hide4096/TadpoleEx/README.md

# TadpoleEx
第18回全日本学生室内飛行ロボットコンテスト自動操縦部門に出場した機体のプログラムと回路図
