hide4096/TadpoleEx/PCB/README.md

# 2022TadpoleEx_KiCAD
第18回飛行ロボットコンテスト自動操縦部門 TadpoleEx用基板
