hide4096/TadpoleEx/CAD/notuse/Ultrasonic_holderV2.stl

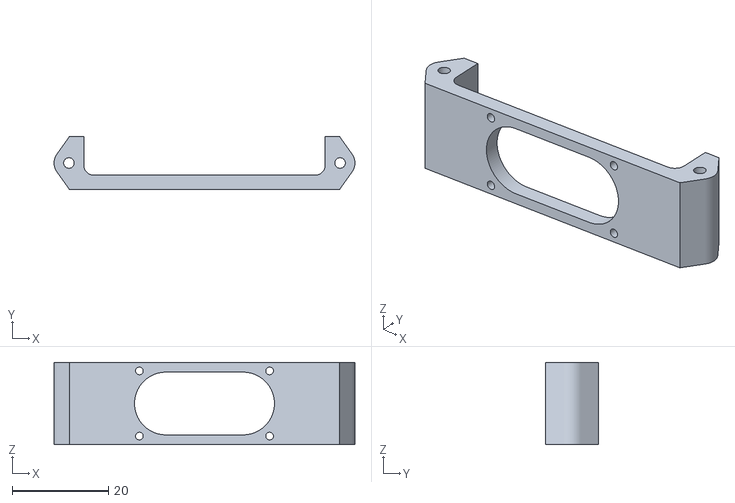
[picture p1: CAD file, 2022-12-09]
CAD/notuse/Ultrasonic_holderV2.stl
62.4 x 11.0 x 17.0
