hide4096/TadpoleEx/(list of files, cad)

Other CAD files:
CAD/TadpoleEx/TailWing.dwg
CAD/TadpoleEx/om_Body_3.0.dwg
CAD/TadpoleEx/om_Body_2.0.dwg
CAD/TadpoleEx/Band_Cap.ipt
CAD/TadpoleEx/Drop/OldVersions/neji.0001.ipt
CAD/TadpoleEx/Drop/OldVersions/om_Drop.0025.iam
CAD/TadpoleEx/Drop/OldVersions/om_DropBase.0005.ipt
CAD/TadpoleEx/Drop/OldVersions/om_DropBase_10g.0002.ipt
CAD/TadpoleEx/Drop/OldVersions/om_DropBase_8g.0001.ipt
CAD/TadpoleEx/Drop/OldVersions/om_Drop_10g.0004.iam
CAD/TadpoleEx/Drop/OldVersions/om_Drop_10g_L.0001.ipt
CAD/TadpoleEx/Drop/OldVersions/om_Drop_10g_R.0001.ipt
CAD/TadpoleEx/Drop/OldVersions/om_Drop_L.0012.ipt
CAD/TadpoleEx/Drop/OldVersions/om_Drop_R.0021.ipt
CAD/TadpoleEx/Drop/OldVersions/om_Drop_bumper.0007.ipt
CAD/TadpoleEx/Drop/OldVersions/om_Drop_shaft.0004.ipt
CAD/TadpoleEx/Drop/OldVersions/om_Drop_shaft_10g.0001.ipt
CAD/TadpoleEx/Drop/joint.ipt
CAD/TadpoleEx/Drop/neji.ipt
CAD/TadpoleEx/Drop/om_Drop.iam
CAD/TadpoleEx/Drop/om_DropBase.ipt
CAD/TadpoleEx/Drop/om_DropBase_10g.ipt
CAD/TadpoleEx/Drop/om_Drop_10g.iam
CAD/TadpoleEx/Drop/om_Drop_10g_L.ipt
CAD/TadpoleEx/Drop/om_Drop_10g_R.ipt
CAD/TadpoleEx/Drop/om_Drop_L.ipt
CAD/TadpoleEx/Drop/om_Drop_R.ipt
CAD/TadpoleEx/Drop/om_Drop_bumper.ipt
CAD/TadpoleEx/Drop/om_Drop_shaft.ipt
CAD/TadpoleEx/Drop/om_Drop_shaft_10g.ipt
CAD/TadpoleEx/Drop/saponSEX_ver3.iam
CAD/TadpoleEx/HoriMove.ipt
CAD/TadpoleEx/HoriWing.ipt
CAD/TadpoleEx/HornHolder.ipt
CAD/TadpoleEx/MainMotor._Newipt.ipt
CAD/TadpoleEx/MainMotor.ipt
CAD/TadpoleEx/MainRod.ipt
CAD/TadpoleEx/MainWing.ipt
CAD/TadpoleEx/MainWing_3.0.ipt
CAD/TadpoleEx/MainWing_4.0.ipt
CAD/TadpoleEx/MainWing_5.0.ipt
CAD/TadpoleEx/MainWing_flat_印刷.ipt
CAD/TadpoleEx/MainWing_印刷.ipt
CAD/TadpoleEx/OldVersions/MainWing_5.0.0005.ipt
CAD/TadpoleEx/OldVersions/om_HIKOROBO_3.0.0022.iam
CAD/TadpoleEx/Propeller.ipt
CAD/TadpoleEx/ServoMotor.ipt
CAD/TadpoleEx/ServoMotor_10g.ipt
CAD/TadpoleEx/ServoMotor_8g.ipt
CAD/TadpoleEx/ServoMotor_Holder.ipt
CAD/TadpoleEx/ServoMotor_Holder_V2.ipt
CAD/TadpoleEx/TailHorn.ipt
CAD/TadpoleEx/Tail_Set.iam
CAD/TadpoleEx/Tire_Φ50.ipt
CAD/TadpoleEx/VertMove.ipt
CAD/TadpoleEx/VertWing.ipt
CAD/TadpoleEx/Wheel_Φ50.ipt
CAD/TadpoleEx/WireHolder.ipt
CAD/TadpoleEx/chicken.ipt
CAD/TadpoleEx/horn.ipt
CAD/TadpoleEx/horn_10g.ipt
CAD/TadpoleEx/kiban.ipt
CAD/TadpoleEx/kibanHolder.ipt
CAD/TadpoleEx/om_BackHolder.ipt
CAD/TadpoleEx/om_BackHolder_R.ipt
CAD/TadpoleEx/om_BackHolder_V2.ipt
CAD/TadpoleEx/om_BackHolder_V3.ipt
CAD/TadpoleEx/om_BackHolder_V4.ipt
CAD/TadpoleEx/om_Body_2.0.idw
CAD/TadpoleEx/om_Body_2.0.ipt
CAD/TadpoleEx/om_Body_3.0.ipt
CAD/TadpoleEx/om_Body_L.ipt
CAD/TadpoleEx/om_Body_R.ipt
CAD/TadpoleEx/om_Drop.idw
CAD/TadpoleEx/om_HIKOROBO.iam
CAD/TadpoleEx/om_HIKOROBO_2.0.iam
CAD/TadpoleEx/om_HIKOROBO_3.0.iam
CAD/TadpoleEx/om_Interior.iam
CAD/TadpoleEx/om_Interior_2.0.iam
CAD/TadpoleEx/om_MotorMount.ipt
CAD/TadpoleEx/om_MotorMount_2.0.ipt
CAD/TadpoleEx/om_MotorMount_2.1.ipt
CAD/TadpoleEx/om_MotorMount_3.0.ipt
CAD/TadpoleEx/om_MotorMount_4.0.ipt
CAD/TadpoleEx/om_MotorMount_4.1.ipt
CAD/TadpoleEx/om_TailFrontHolder.ipt
CAD/TadpoleEx/om_TailFrontHolder_FP.ipt
CAD/TadpoleEx/om_TailRod.ipt
CAD/TadpoleEx/om_TailRod_FP.ipt
CAD/notuse/Gear/GearBase.ipt
CAD/notuse/Gear/GearV1.iam
CAD/notuse/Gear/Holder's Shaft.ipt
CAD/notuse/Gear/OldVersions/GearBase.0009.ipt
CAD/notuse/Gear/OldVersions/GearV1.0013.iam
CAD/notuse/Gear/OldVersions/gear_connecotr1.0016.ipt
CAD/notuse/Gear/OldVersions/gear_connecotr1_V2.0001.ipt
CAD/notuse/Gear/OldVersions/gear_connector2.0013.ipt
CAD/notuse/Gear/OldVersions/gear_rod.0005.ipt
CAD/notuse/Gear/OldVersions/gear_shaft.0001.ipt
CAD/notuse/Gear/OldVersions/om_gear_base1.0007.ipt
CAD/notuse/Gear/Tire_Φ50.ipt
CAD/notuse/Gear/Wheel_Φ50.ipt
CAD/notuse/Gear/Wheel_Φ50.newVer.ipt
CAD/notuse/Gear/gear_connecotr1.ipt
CAD/notuse/Gear/gear_connecotr1_V2.ipt
CAD/notuse/Gear/gear_connector2.ipt
CAD/notuse/Gear/gear_rod.ipt
CAD/notuse/Gear/gear_shaft1.ipt
CAD/notuse/Gear/gear_test.iam
CAD/notuse/Gear/om_gear_base1.ipt
CAD/notuse/Gear/om_gear_base2.ipt
CAD/notuse/UltrasonicSensor.ipt
CAD/notuse/Ultrasonic_holderV1.ipt
CAD/notuse/Ultrasonic_holderV2.ipt
CAD/notuse/Ultrasonic_holderV3.ipt
CAD/notuse/Ultrasonic_holderV4.ipt
CAD/notuse/Ultrasonic_holderV5.ipt
