hide4096/TadpoleEx/Fc_esp32.pdf

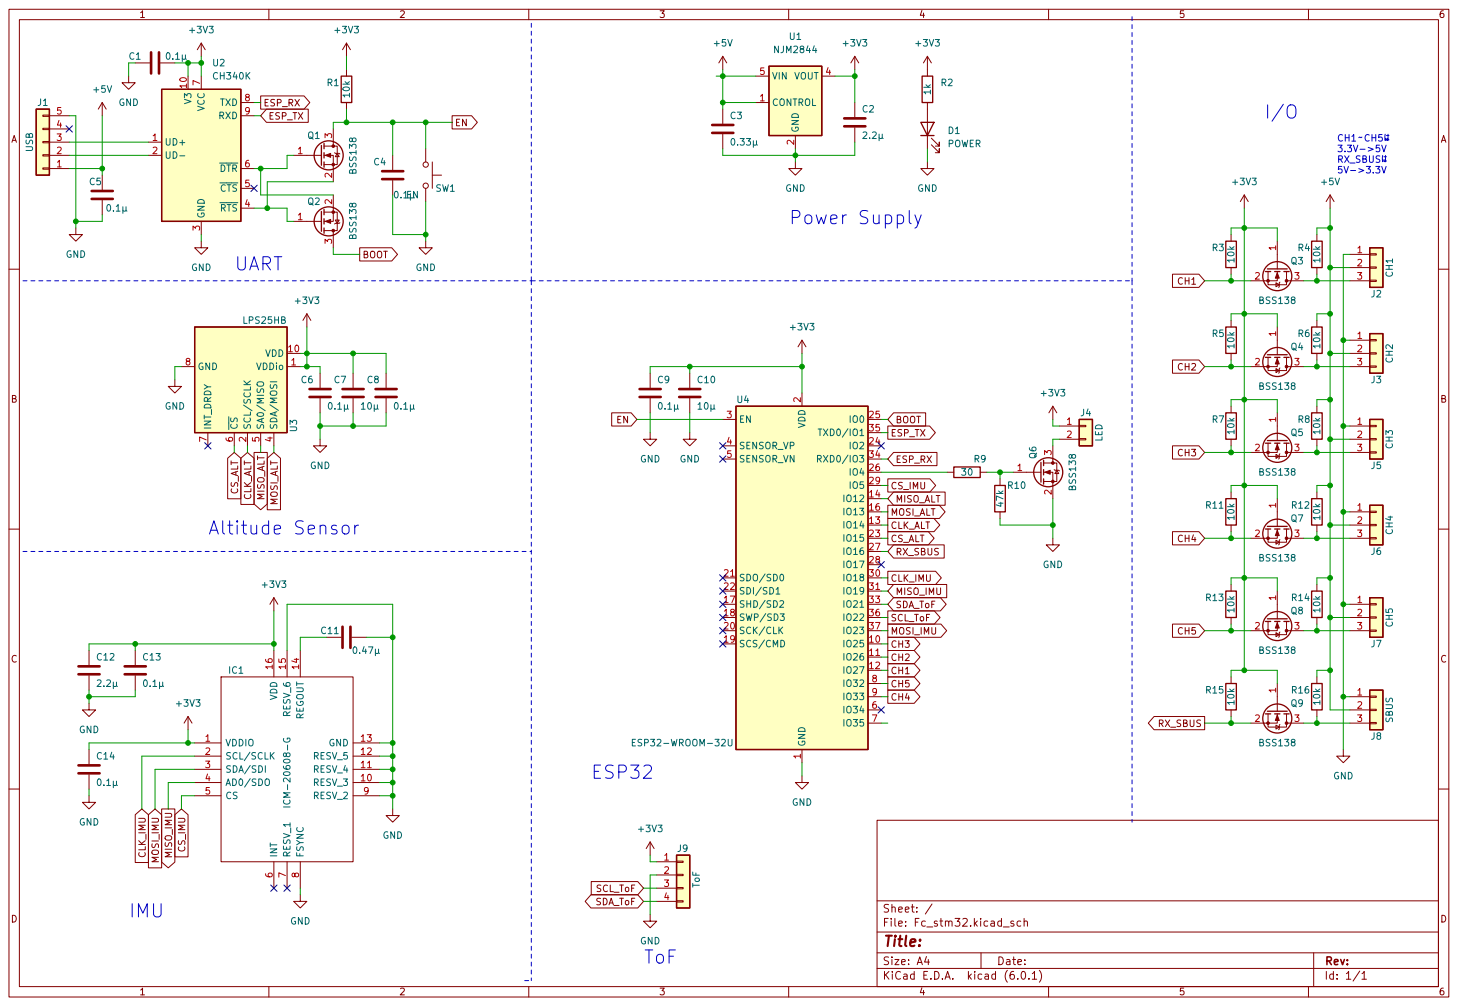
[picture p2: page 1]

3 ~{RTS} 4 ~{CTS} 5 ~{DTR} 6 VCC

2 SCK/CLK 20 SDO/SD0 21 SDI/SD1 22
