hide4096/TadpoleEx/(commit log)

2022-08-22 [update]IMU,大気圧センサのドライバ書いた
2022-08-27 [update]サーボ制御をマルチスレッド化
2022-08-27 [update]UDP通信追加
2022-08-28 [fix]フリーズを修正
2022-08-28 [update]自動水平旋回を実装
2022-08-28 [fix]放送内容を変更
2022-08-28 [update]ログで吐く情報を追加
2022-08-29 [update]角速度を指定して旋回できるようにした
2022-08-30 [update]ToF追加
2022-09-02 [add]基板データ追加
    [Fc_stm32.kicad_pcb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]
2022-09-10 [update]Adjust PID Gain and altitude LPF Gain
2022-09-15 [fix] 着陸誘導方式を変更
2022-09-18 [update]自動操縦動画提出版
2022-09-21 [update]自動旋回のゲインを調整
2022-09-21 [update]全ミッション実装
2022-09-21 [fix]ヨーのアレを修正
2022-09-22 [update]ゲインを調整
2022-09-22 [updare]ゲインを調整
2022-09-22 [final]ゲインを調整
2022-09-24 [last]ゲイン調整
2022-09-25 [fix]WiFiAPをスマホのテザリングに変更
2022-09-27 [final]決勝出場
2022-09-27 [add]公開用に書き換え
2022-10-28 [add]README書いた
2022-10-28 [fix]ライセンスを明記
    [Fc_stm32.kicad_pcb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]
2022-10-28 [add]全部出す
    [Fc_stm32.kicad_pcb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]
2022-12-09 [add]CADデータ追加
    [Band_Cap.ipt, GearBase.0009.ipt, GearBase.ipt, GearV1.0013.iam, GearV1.iam, Holder's Shaft.ipt, HoriMove.ipt, HoriWing.ipt]
2022-12-09 [add]gitignode書いた
2022-12-09 [fix]キャッシュを削除
    [Band_Cap.ipt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]
2022-12-09 [fix]キャッシュ削除
    [Band_Cap.ipt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]
